Nunezjhon/Smart-Lock/README.md

<h3> Created by: Jhon Nunez and Christian Dominguez </h3>
<h4> University of Illinois at Chicago </h4>

Computer Design Final Project "Smart Lock" by Jhon Nunez and Christian Dominguez

SMART_LOCK.pdf 				-> Documentation for Final Project
FINAL_PROJECT and Final_Arduino 2 	-> Arduino files
VIDEO 					-> Link to project video
