Nunezjhon/Smart-Lock/README.txt

Created by: Jhon Nunez and Christian Dominguez 
University of Illinois at Chicago 

Computer Design Final Project "Smart Lock" by Jhon Nunez and Christian Dominguez

SMART_LOCK.pdf 				-> Documentation for Final Project
FINAL_PROJECT and Final_Arduino 2 	-> Arduino files
VIDEO 					-> Link to project video
